gb2835/Prosthesis-v2-PCBA/Documents/_Figures.pptx

2X LOAD CELL

ANALOG VOLTAGE

2X PWM

2X IMU

SPI

I2C

MCU

CAN_TX

CAN_RX

CAN
TRANSCEIVER

3.7 V LiPo BATTERY

CAN_H

CAN_L

2X MOTOR DRIVER

2X MAG ENCODER

COMPUTER

USB-C

SD CARD

BOARD

SSI

Battery Charging
