gb2835/Prosthesis-v2-PCBA/Documents/Project Description.docx

PROJECT DESCRIPTION

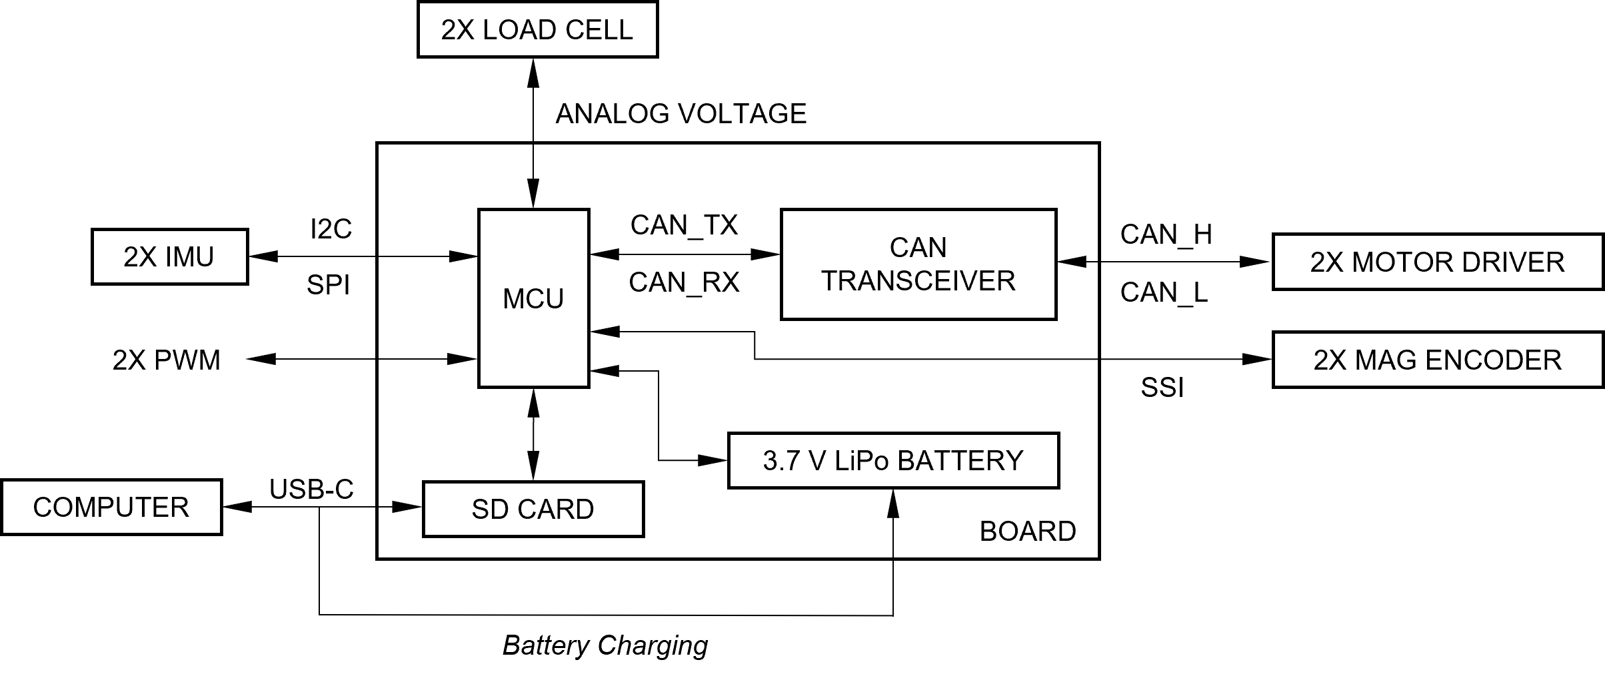
[picture p1: figure]

Component | P/N | Supplier
MCU | STM32L476RG | STMicroelectronics
SD Card | DM3CS-SF | Hirose Electric Co Ltd
USB-C | Your choice | Your choice
Mag Encoder | AS5145B | ams-OSRAM USA INC.
Motor Driver | G_SOLTWI25/100SE8S ODRIVE S1 | Elmo Motion Control ODrive
IMU Attached to breakout board | BNO085 Link (https://www.adafruit.com/product/4754) | CEVA Technologies, Inc. Adafruit
Load Cell | AD22151 | Analog Devices Inc.
CAN Transceiver | MCP2551 | Microchip Technology
Battery | ??? | ???

Questions

1. Did you have a particular battery in mind?

Notes

1. The connectors we use are 44055-x by TE Connectivity.
2. LED indicator.
  a. Solid = power on
  b. Blinking = low power
  c. Anything else, have fun with it
3. Get quotes for populated and unpopulated boards.
4. SD Card and LED(s) should be on top side of board.
5. I will provide desired board outline with mounting holes, connector locations, etc.
6. Let MCU access all INT pins.
7. Include headers for unused pins.
8. Include switch for on/off power. We use this (https://www.digikey.com/en/products/detail/e-switch/EG1218/101726).
9. Include test point for a dedicated GPIO pin used to measure on oscilloscope.
10. Include test point for GND.
11. Board thickness 1.6 mm.

Greg TODOs

1. IMU connector pin spec
  a. What signals, how many pins?
    i. VDD
    ii. GND
    iii. I2C or SPI or whichever its motion processor uses
    iv. INT
2. Load Cell connector pin spec
  a. VCC
  b. GND
  c. Analog 1
  d. Analog 2
3. PWM pin spec
  a. What signals, how many pins
    i. PWM
    ii. GND
4. Mag encoder pin spec
  a. What signals, how many pins
    i. Data out
    ii. Clock
    iii. Chip select
    iv. VDD
    v. VSS (I think this is just GND?)
    vi. INT if it is available?
5. LEDs
  a. Preference on top mount, or right angle?
    i. Top mount
  b. Full color RGB?
    i. Up to you
  c. Multiple?
    i. Up to you
6. Battery
  a. Runtime needed?
    i. An hour would be great
  b. Where, how much space to mount? Bottom/top?
    i. Top side on the right
    ii. The space depends on the size of the battery, you would have to tell me. We can discuss more on including a printed holder
  c. Connector vs direct solder?
    i. I would probably say connector but we can discuss
  d. Reverse protection is doable, reverse operation not worth it.
    i. Direct solder no reverse issue
      1. Understood, protection only is good
