gb2835/Prosthesis-v2-PCBA/ECAD/Project Outputs/Prosthesis.xlsx

Line # | Comment | Footprint | Description | Designator | Quantity | Part Number | PartNumber
 | B2B-PH-K-S(LF)(SN) | JST-B2B-PH-K-S_V | Male Header, Pitch 2 mm, 1 x 2 Position, Height 6 mm, Tail Length 3.4 mm, -25 to 85 degC, RoHS, Bulk | BATT1 | 1
 | GRM21BR61C106KE15L | FP-GRM21B-0_1-IPC_C | Chip Multilayer Ceramic Capacitors for General Purpose, 0805, 10uF, X5R, 15%, 10%, 16V | C1 | 1
 | GRM21BR61C106KE15L | FP-GRM21B-0_1-IPC_C | Chip Multilayer Ceramic Capacitors for General Purpose, 0805, 10uF, X5R, 15%, 10%, 16V | C2 | 1
 | GRM21BR61C106KE15L | FP-GRM21B-0_1-IPC_C | Chip Multilayer Ceramic Capacitors for General Purpose, 0805, 10uF, X5R, 15%, 10%, 16V | C3 | 1
 | GRM21BR61C106KE15L | FP-GRM21B-0_1-IPC_C | Chip Multilayer Ceramic Capacitors for General Purpose, 0805, 10uF, X5R, 15%, 10%, 16V | C4 | 1
 | GRM21BR61C106KE15L | FP-GRM21B-0_1-IPC_C | Chip Multilayer Ceramic Capacitors for General Purpose, 0805, 10uF, X5R, 15%, 10%, 16V | C5 | 1
 | CC0805KRX7R7BB104 | FP-CC0805-0_85-MFG | CAP CER 0.1UF 16V X7R 0805 | C6 | 1
 | GRM21BR61C106KE15L | FP-GRM21B-0_1-IPC_C | Chip Multilayer Ceramic Capacitors for General Purpose, 0805, 10uF, X5R, 15%, 10%, 16V | C7 | 1
 | GRM21BR61C106KE15L | FP-GRM21B-0_1-IPC_C | Chip Multilayer Ceramic Capacitors for General Purpose, 0805, 10uF, X5R, 15%, 10%, 16V | C8 | 1
 | GRM21BR61C106KE15L | FP-GRM21B-0_1-IPC_C | Chip Multilayer Ceramic Capacitors for General Purpose, 0805, 10uF, X5R, 15%, 10%, 16V | C9 | 1
 | CC0805KRX7R7BB104 | FP-CC0805-0_85-MFG | CAP CER 0.1UF 16V X7R 0805 | C10 | 1
 | GRM21BR61C106KE15L | FP-GRM21B-0_1-IPC_C | Chip Multilayer Ceramic Capacitors for General Purpose, 0805, 10uF, X5R, 15%, 10%, 16V | C11 | 1
 | GRM21BR61C106KE15L | FP-GRM21B-0_1-IPC_C | Chip Multilayer Ceramic Capacitors for General Purpose, 0805, 10uF, X5R, 15%, 10%, 16V | C12 | 1
 | GRM21BR61C106KE15L | FP-GRM21B-0_1-IPC_C | Chip Multilayer Ceramic Capacitors for General Purpose, 0805, 10uF, X5R, 15%, 10%, 16V | C13 | 1
 | CC0805KRX7R7BB104 | FP-CC0805-0_85-MFG | CAP CER 0.1UF 16V X7R 0805 | C14 | 1
 | CC0805KRX7R7BB104 | FP-CC0805-0_85-MFG | CAP CER 0.1UF 16V X7R 0805 | C15 | 1
 | CC0805KRX7R7BB104 | FP-CC0805-0_85-MFG | CAP CER 0.1UF 16V X7R 0805 | C16 | 1
 | CC0805KRX7R7BB104 | FP-CC0805-0_85-MFG | CAP CER 0.1UF 16V X7R 0805 | C17 | 1
 | CC0805KRX7R7BB104 | FP-CC0805-0_85-MFG | CAP CER 0.1UF 16V X7R 0805 | C18 | 1
 | CC0805KRX7R7BB104 | FP-CC0805-0_85-MFG | CAP CER 0.1UF 16V X7R 0805 | C20 | 1
 | 32pF | FP-CC0805-0_85-MFG | CAP CER 32pF 16V X7R 0805 | C21 | 1
 | 32pF | FP-CC0805-0_85-MFG | CAP CER 32pF 16V X7R 0805 | C22 | 1
 | GRM21BR61C106KE15L | FP-GRM21B-0_1-IPC_C | Chip Multilayer Ceramic Capacitors for General Purpose, 0805, 10uF, X5R, 15%, 10%, 16V | C23 | 1
 | CC0805KRX7R7BB104 | FP-CC0805-0_85-MFG | CAP CER 0.1UF 16V X7R 0805 | C24 | 1
 | CC0805KRX7R7BB104 | FP-CC0805-0_85-MFG | CAP CER 0.1UF 16V X7R 0805 | C25 | 1
 | GRM21BR61C106KE15L | FP-GRM21B-0_1-IPC_C | Chip Multilayer Ceramic Capacitors for General Purpose, 0805, 10uF, X5R, 15%, 10%, 16V | C26 | 1
 | CC0805KRX7R7BB104 | FP-CC0805-0_85-MFG | CAP CER 0.1UF 16V X7R 0805 | C27 | 1
 | GRM21BR61C106KE15L | FP-GRM21B-0_1-IPC_C | Chip Multilayer Ceramic Capacitors for General Purpose, 0805, 10uF, X5R, 15%, 10%, 16V | C28 | 1
 | CC0805KRX7R7BB104 | FP-CC0805-0_85-MFG | CAP CER 0.1UF 16V X7R 0805 | C29 | 1
 | TLMS1000-GS08 | VISH-TLMS1000_V | Low Current LED, 40 mW, 1.8 V, -40 to 100 degC, 2-Pin SMD (0603), RoHS, Tape and Reel | CHRG | 1
 | 501331-0607 | FP-501331-0607-MFG | CONN HEADER SMD 6POS 1MM | ENC1 | 1
 | 501568-0607 | FP-501568-0607-MFG | CONN HEADER SMD R/A 6POS 1MM | ENC2 | 1
 | 2023961207 | MOLEX_2023961207 |  | IMU1 | 1
 | 501331-1207 | FP-501331-1207-MFG | CONN HEADER SMD 12POS 1MM | IMU2 | 1
 | DM3CS-SF | FP-DM3CS-SF-MFG | CONN MICRO SD CARD HINGED TYPE | J1 | 1
 | 2137160001 | FP-2137160001-MFG | 2137160001 Conn USB 2.0 Type C F 16 POS 0.85mm Solder RA Thru-Hole 16 Terminal 1 Port T/R | J2 | 1
 | 74404041047 | WE-LQS_4012 | 74404041047 Inductors, Fixed, WE-LQS SMD 4012 4.7uH 1.55A 91mOhms | L1 | 1
 | LPS3015-152MRB | FP-LPS3015-MFG | Fixed Inductors LPS3015 AEC-Q200 1.5uH 1.4A 20% SMD | L2 | 1
 | 501331-0607 | FP-501331-0607-MFG | CONN HEADER SMD 6POS 1MM | LC1 | 1
 | 501568-0607 | FP-501568-0607-MFG | CONN HEADER SMD R/A 6POS 1MM | LC2 | 1
 | 2023960407 | MOLEX_2023960407 |  | MOTOR | 1
 | EG1218 | ESWI-EG1218_V | Slide Switch, 500 V, -20 to 70 degC, 3-Pin THD, RoHS | ON1 | 1
 | 501568-0407 | FP-501568-0407-MFG | CONN HEADER SMD R/A 4POS 1MM | PROG | 1
 | 501568-0407 | FP-501568-0407-MFG | CONN HEADER SMD R/A 4POS 1MM | PWM1 | 1
 | LTST-C190GKT | FP-LTST-C190GKT-MFG | LED GREEN CLEAR CHIP SMD | PWR | 1
 | FDN337N | FP-527AG-MFG | MOSFET N-CH 30V 2.2A SSOT3 | Q1 | 1
 | 2N7002LT3G | ONSC-SOT-23-3-318-08_V | Small Signal MOSFET, 60 V, 115 mA, N-Channel, 3-Pin SOT-23, Pb-Free, Tape and Reel | Q2 | 1 |  | 2N7002LT3G
 | ERJ-6ENF1181V | RESC2013X70X40ML20T20 |  | R1 | 1 | ERJ-6ENF1181V
 | ERJ-6GEYJ152V | RESC2013X70X40NL20T20 |  | R2 | 1 | ERJ-6GEYJ152V
 | ERJ-6GEYJ473V | RESC2013X70X40ML20T20 |  | R3 | 1 | ERJ-6GEYJ473V
 | ERJ-6GEYJ152V | RESC2013X70X40NL20T20 |  | R4 | 1 | ERJ-6GEYJ152V
 | RC0805FR-071K13L | RESC2013X60X35NL10T20 |  | R5 | 1 | RC0805FR-071K13L
 | ERJ6ENF5601V | RESC2013X60X35NL10T20 | Chip Resistor, 10 KOhm, +/- 1%, 0.125 W, -55 to 155 degC, 0805 (2012 Metric), RoHS, Tape and Reel | R6 | 1
 | ERJ-3GEYJ105V | RESC1608X55X30NL15T15 |  | R7 | 1 | ERJ-3GEYJ105V
 | RG2012N-184-W-T1 | RESC2013X50X40NL20T20 |  | R8 | 1 | RG2012N-184-W-T1
 | ERA-6YEB512V | RESC2013X60X40LL20T25 |  | R9 | 1 | ERA-6YEB512V
 | ERA6AEB101V | RESC2013X60X40ML20T25 |  | R10 | 1 | ERA6AEB101V
 | ERA6AEB101V | RESC2013X60X40ML20T25 |  | R11 | 1 | ERA6AEB101V
 | ERA6AEB101V | RESC2013X60X40ML20T25 |  | R12 | 1 | ERA6AEB101V
 | ERA-6YEB512V | RESC2013X60X40LL20T25 |  | R13 | 1 | ERA-6YEB512V
 | ERJ6ENF5601V | RESC2013X70X40LL20T20 |  | R14 | 1 | ERJ6ENF5601V
 | ERJ6ENF5601V | RESC2013X70X40LL20T20 |  | R15 | 1 | ERJ6ENF5601V
 | ERJ6ENF5601V | RESC2013X70X40LL20T20 |  | R16 | 1 | ERJ6ENF5601V
 | ERJ6ENF5601V | RESC2013X70X40LL20T20 |  | R17 | 1 | ERJ6ENF5601V
 | ERJ6ENF5601V | RESC2013X70X40LL20T20 |  | R18 | 1 | ERJ6ENF5601V
 | ERJ6ENF5601V | RESC2013X70X40LL20T20 |  | R19 | 1 | ERJ6ENF5601V
 | ERJ6ENF5601V | RESC2013X70X40LL20T20 |  | R20 | 1 | ERJ6ENF5601V
 | ERJ6ENF5601V | RESC2013X70X40LL20T20 |  | R21 | 1 | ERJ6ENF5601V
 | ERA6AEB121V | RESC2013X60X40ML20T25 |  | R22 | 1 | ERA6AEB121V
 | ERJ6ENF5601V | RESC2013X70X40LL20T20 |  | R23 | 1 | ERJ6ENF5601V
 | SML-LX0404SIUPGUSB | FP-SML-LX0404SIUPGUSB-MFG | LED RGB CLEAR SMD | RGB1 | 1
 | KSTN-5003 | KSTN-5003 | Test Point, Orange, 1-Pin THD, RoHS | GND | 1
 | KSTN-5003 | KSTN-5003 | Test Point, Orange, 1-Pin THD, RoHS | TP2 | 1
 | TPS61222DCKT | DCK0006A_N | Boost Voltage Converter with 0.7 to 5.5 V Input and 5 V Output, -40 to 85 degC, 6-Pin SC70 (DCK), Green (RoHS & no Sb/Br) | U1 | 1 |  | TPS61222DCKT
 | BQ24074RGTR | FP-RGT0016C-IPC_B | IC LI-ION CHARGE MGMT 16-QFN | U2 | 1
 | TPS63030DSKT | FP-DSK0010A-IPC_B | IC REG BCK BST ADJ 900MA 10SON | U3 | 1
 | STM32L476RGT3 | FP-LQFP64-5W-IPC_C | IC MCU 32BIT 1MB FLASH 64LQFP | U4 | 1
 | SN65HVD230DR | FP-D0008A-IPC_A | IC TRANSCEIVER HALF 1/1 8SOIC | U5 | 1
 | ABM3B-48.000MHZ-B2-T | FP-ABM3B-MFG | Crystal 48MHz ±20ppm 18pF SMD-4 5mm x 3.2mm | Y1 | 1
