gb2835/Prosthesis-v2-PCBA/(list of files, cad)

Other CAD files:
Documents/Board Outline.SLDPRT
Documents/Board Outline.DXF
