gb2835/Prosthesis-v2-PCBA/(list of files, drawings)

Other design files:
Documents/Connector Locations.PcbDoc
ECAD/Prosthesis1/prosthesis.PcbLib
ECAD/Prosthesis1/Prosthesis.SCHLIB
ECAD/Prosthesis1/SamacSys.PcbLib
ECAD/Prosthesis.PrjPcb
ECAD/prosthesis.SchDoc
Prosthesis/prosthesis.PcbDoc
