gb2835/Prosthesis-v2-PCBA/Documents/Prototype issues.xlsx

Prosthesis PCBA turn up.
Check | result | notes
Vusb | good | powers charger, v5 and v3.3. | Issues | Resolution
Vswitch | good | changes between Vbatt and off. Vusb overrides. Clearance issue with SD card slot. Relocate switch slightly. | SD Card clearance | Re-solder switch off side of board
V3.3 | good | stable | V5 power pass through | Disabling V5 is pointless, tie EN high.
V5 | good | Power pass through when not enabled. Just tie enable high for better operation | SD Card CD pin not routed | Enable open pin PB2 as input w/ pull-down enabled. Allows FATFS to function.
Prog | good | Able to program. | SD card 1-bit speed limit 12MHz | Add 2.2k pull-ups for increased speed
Oscillator | Good | setup clocks for 48MHz external, runs great | SD card 4-bit speed limit 4.8MHz | Add 2.2k pull-ups for increased speed
TP2 | Good | 1MHz toggle is solid
SDCARD | mix | CD pin not wired to MCU. Can fake with open pin pull down, but will not represent actual card detect.
SDCARD | good | working 1-bit mode at 12MHz. Will try faster, but might need external pull-ups to get to 24MHz
SDCARD | good | working 4-bit mode at 4.8MHz, which is faster than 1-bit. Would need external pull-ups to get to 24MHz
LED Red | good
LED green | good
LED blue | good
V5 | mix | Vout when enabled is 4.89. This is slightly low.
