gb2835/Prosthesis-v2-PCBA/(commit log)

2024-03-28 sch created, added major components. todo list created.
    [Prosthesis.PrjPcb, prosthesis.PcbDoc, prosthesis.SchDoc]
2024-04-04 Added clarification. Also added switch request
2024-04-07 added power schematic. Changed USB-c connector.
    [Prosthesis.PrjPcb, power.SchDoc, prosthesis.SchDoc]
2024-04-14 work on sch. added datasheets and app notes. changed can txvr
    [power.SchDoc, prosthesis.SchDoc]
2024-04-16 more sch work
    [power.SchDoc, prosthesis.SchDoc]
2024-04-19 Initial upload.
    [Board Outline.PcbDoc]
2024-04-19 Corrected dimensions
    [Board Outline.PcbDoc]
2024-04-20 Added board thickness to Note #11
2024-04-20 Added board outline in dxf
    [Board Outline.DXF, Board Outline.PcbDoc, Board Outline.SLDPRT]
2024-04-20 board outline
    [prosthesis.PcbDoc]
2024-04-20 Added mounting holes
    [Board Outline.DXF, Board Outline.SLDPRT]
2024-04-20 sch work
    [power.SchDoc, prosthesis.PcbDoc, prosthesis.SchDoc]
2024-04-20 Added connector locations
    [Connector Locations.PcbDoc]
2024-05-01 Added connections spreadsheet. Updated locations
    [Connections.xlsx, Connector Locations.PcbDoc]
2024-05-02 IMU I2C/SPI added to description
2024-05-02 Changed MCU to 64 pin version
2024-05-05 Corrected connector pitch to 2.000mm
    [Connector Locations.PcbDoc]
2024-06-26 schematic work
    [power.SchDoc, prosthesis.SchDoc]
2024-06-27 power supplies and charger sch finished
    [power.SchDoc]
2024-06-28 more done
    [power.SchDoc, prosthesis.SchDoc]
2024-07-05 sch almost done
    [Connector Locations.PcbDoc, power.SchDoc, prosthesis.SchDoc]
2024-08-05 pcb work
    [Prosthesis.PrjPcb, Prosthesis.SCHLIB, SamacSys.PcbLib, power.SchDoc, prosthesis.PcbLib, prosthesis.SchDoc]
2024-08-11 pcb finished, working on BOM
    [Pick Place for prosthesis.csv, Prosthesis.PrjPcb, Prosthesis.xlsx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]
2024-08-11 finished and quoted
    [Prosthesis.xlsx]
2024-08-13 changes from PCBA vendor
    [Prosthesis.PrjPcb, prosthesis.SchDoc]
2024-08-16 added sto pin to mcu and routed
    [prosthesis.SchDoc]
2024-08-17 broke out extra pins
    [prosthesis.SchDoc]
2024-08-26 updated connections and connector locations
    [Connections.xlsx, Connector Locations.PcbDoc]
2024-08-26 fixing source file version
    [power.SchDoc, prosthesis.SchDoc]
2025-02-04 Added/edited overlays
    [Pick Place for prosthesis.csv, Prosthesis.PrjPcb, Prosthesis.SCHLIB, Prosthesis.xlsx, SamacSys.PcbLib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]
2025-03-08 fix I2C connection to load cells
    [prosthesis.SchDoc]
2025-03-10 Changed total thickness to 1.6mm
2025-07-06 Edited overlays
    [prosthesis.SchDoc]
2025-09-16 SS updates. Added J3 for CAN res
    [prosthesis.SchDoc]
2025-10-17 Updated can resistor silk screen
2025-10-17 Changed rev2 silkscreen to rev1
